Darkone83/Auto-RGB/img/ALS Board Back.png

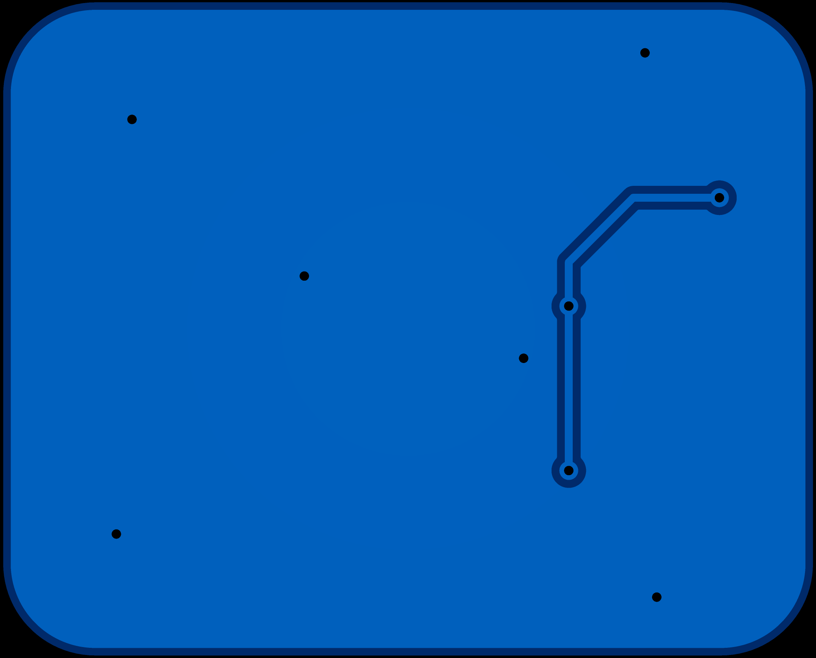
img/ALS Board Back.png
