Darkone83/Auto-RGB/img/ALS Board Front.png

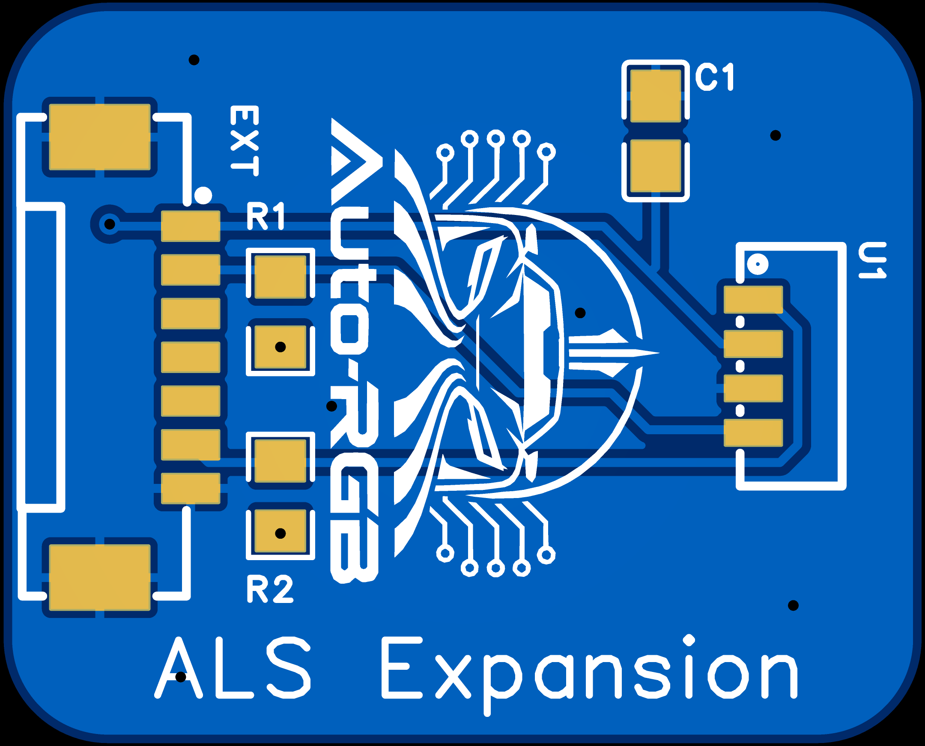
img/ALS Board Front.png
