Darkone83/Auto-RGB/img/ALS Board Schematic.png

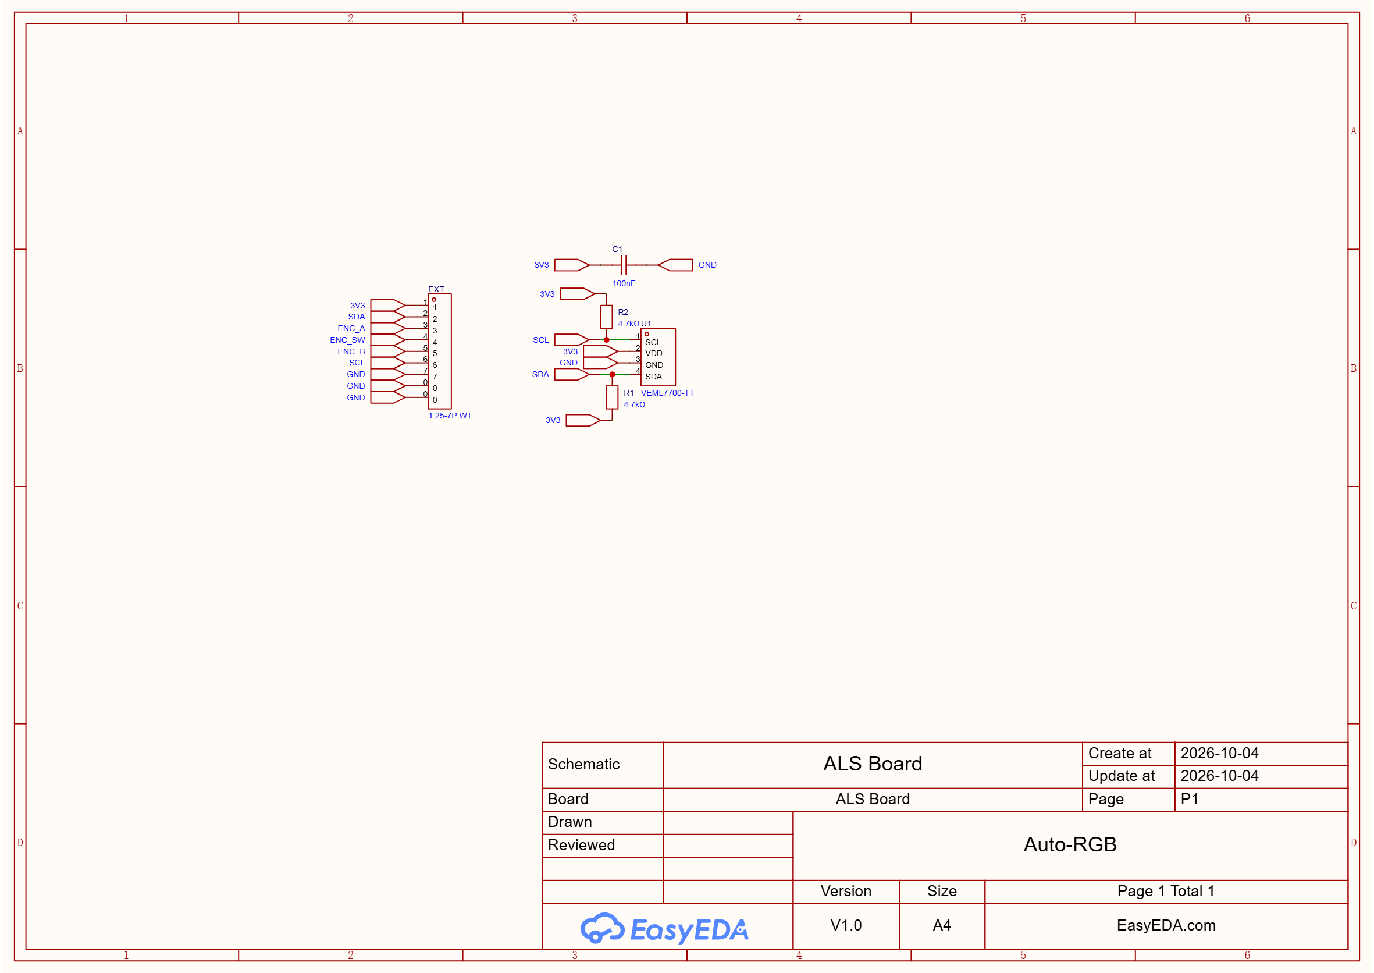
img/ALS Board Schematic.png
