Darkone83/Auto-RGB/img/EXP Hub Back.png

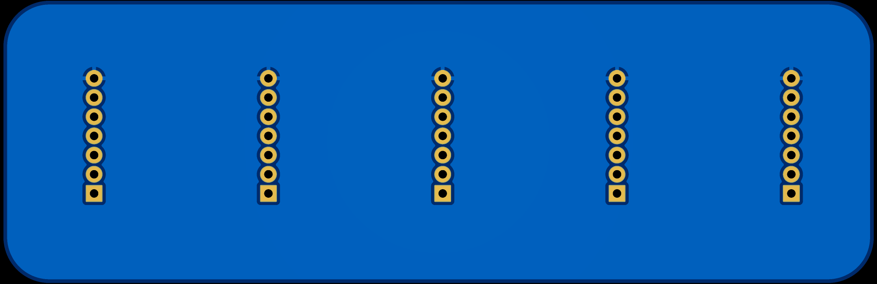
img/EXP Hub Back.png
