Darkone83/Auto-RGB/img/EXP Hub Front.png

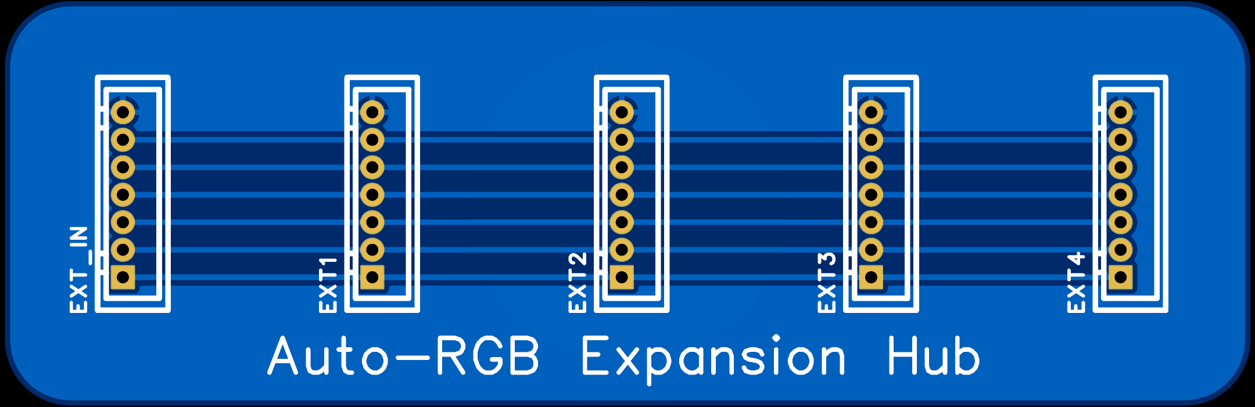
img/EXP Hub Front.png
