Darkone83/Auto-RGB/img/EXP Hub Schematic.png

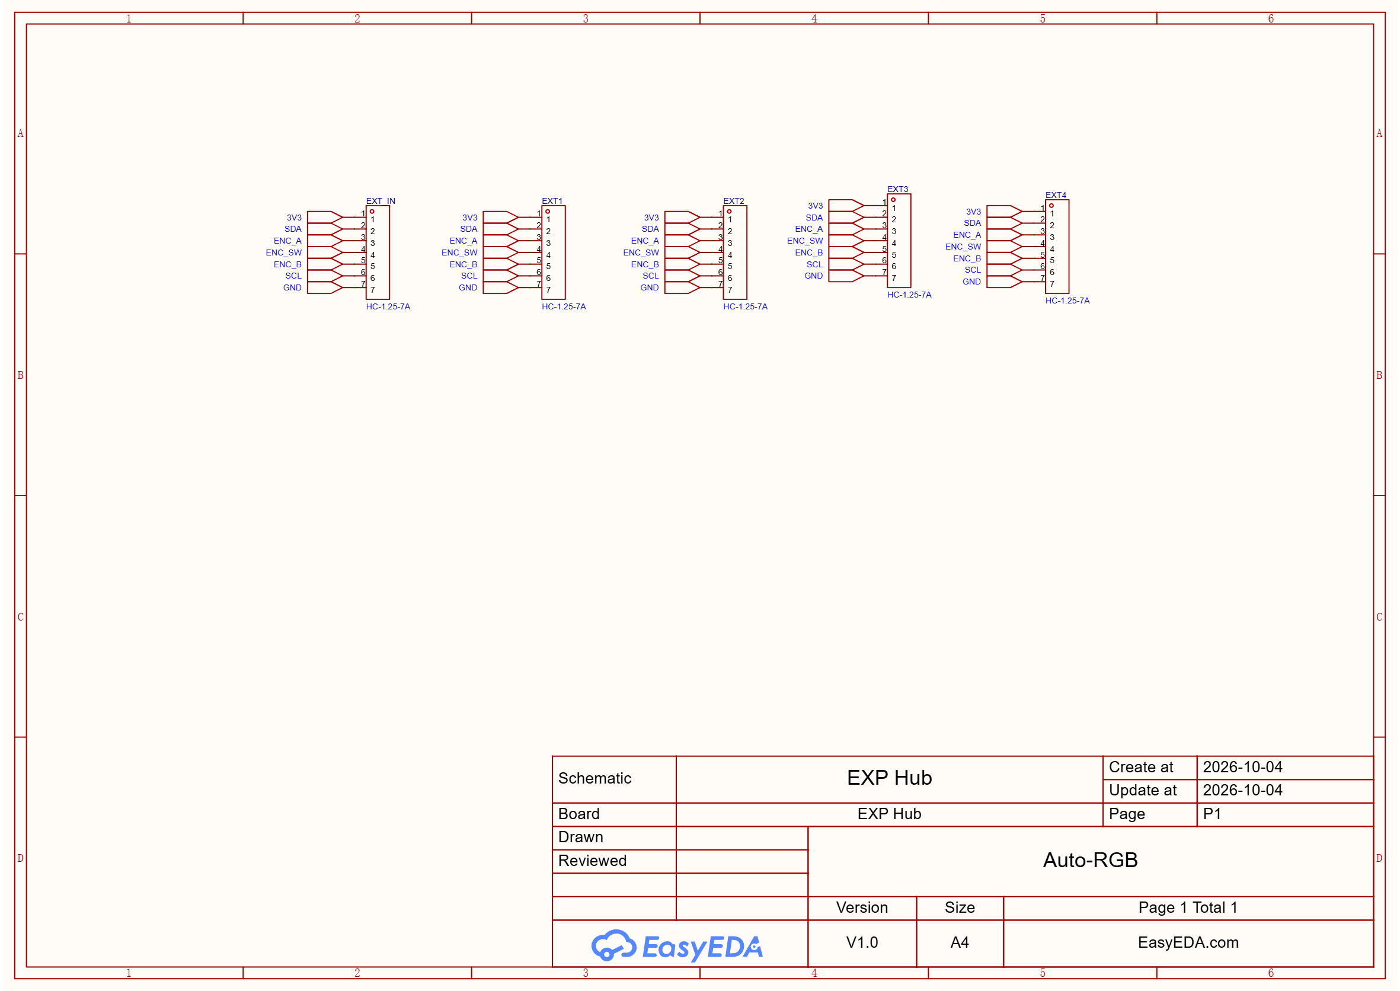
img/EXP Hub Schematic.png
