Darkone83/Auto-RGB/img/LED Board Back.png

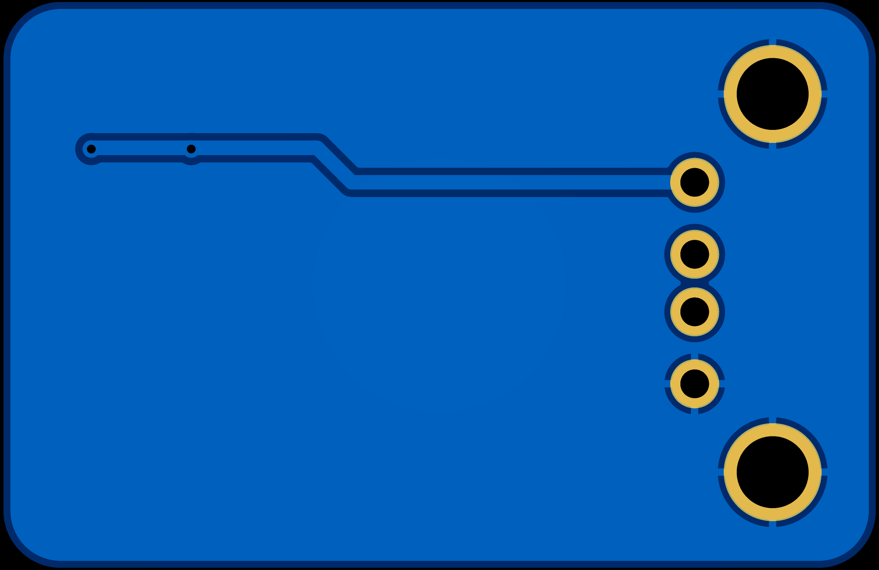
img/LED Board Back.png
