Darkone83/Auto-RGB/img/LED Board Front.png

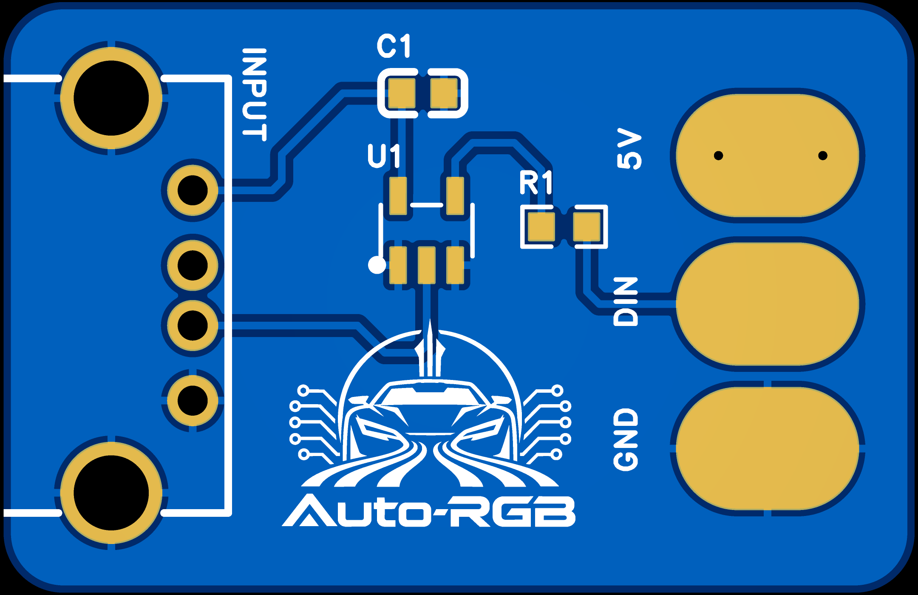
img/LED Board Front.png
