Darkone83/Auto-RGB/img/LED Board Schematic.png

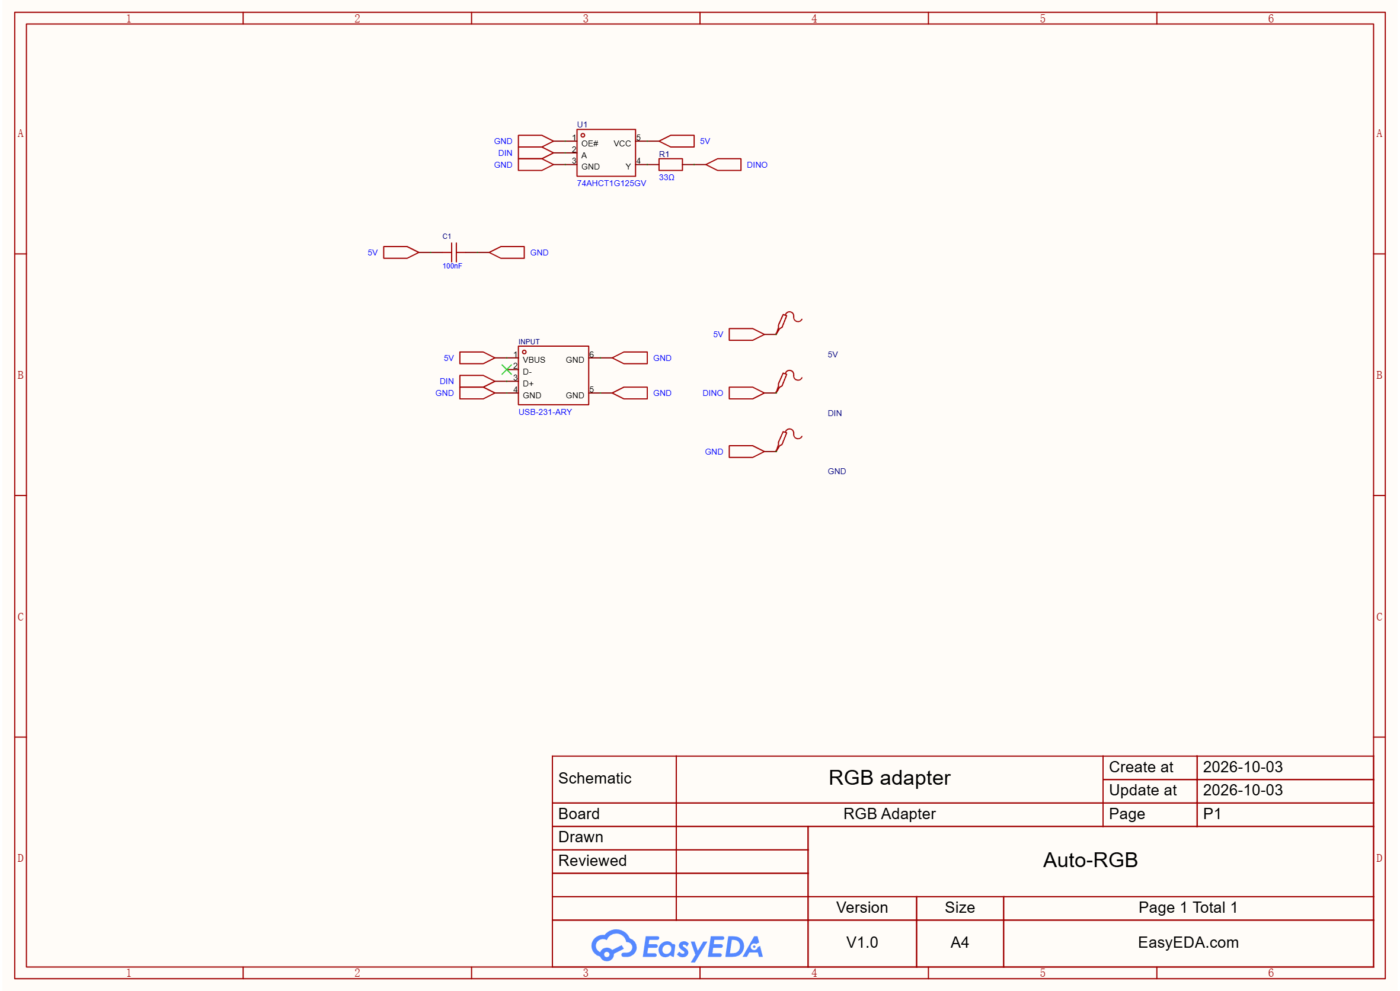
img/LED Board Schematic.png
