Darkone83/Auto-RGB/img/Main Board Back.png

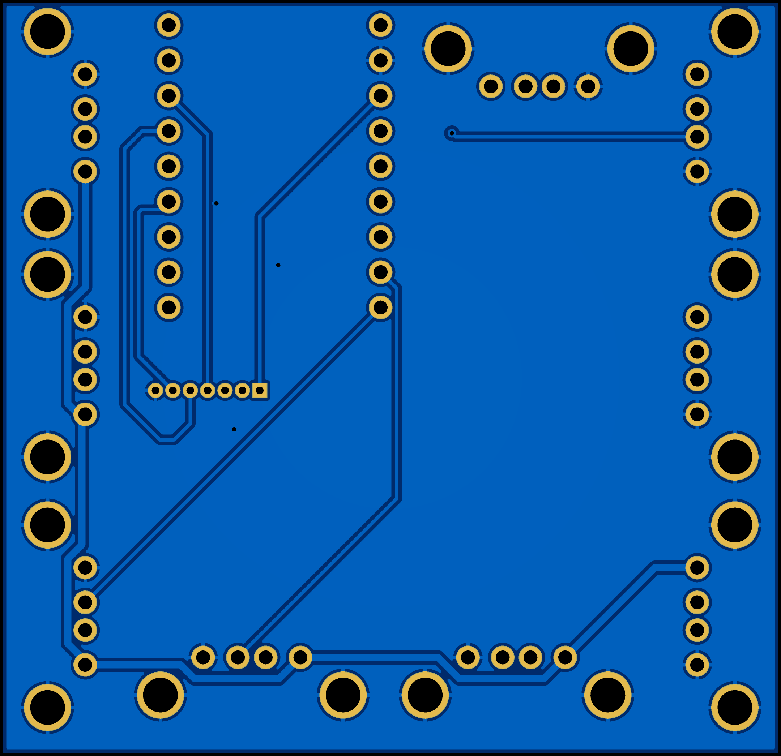
img/Main Board Back.png
