Darkone83/Auto-RGB/img/Main Board Front.png

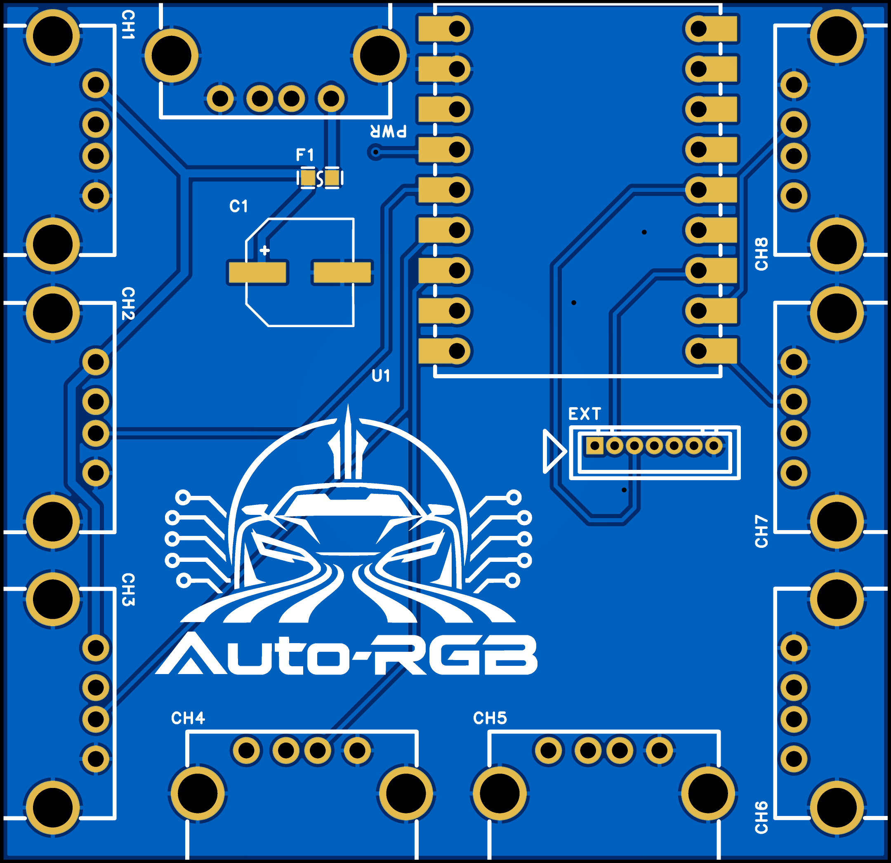
img/Main Board Front.png
