Darkone83/Auto-RGB/img/Main Board Schematic.png

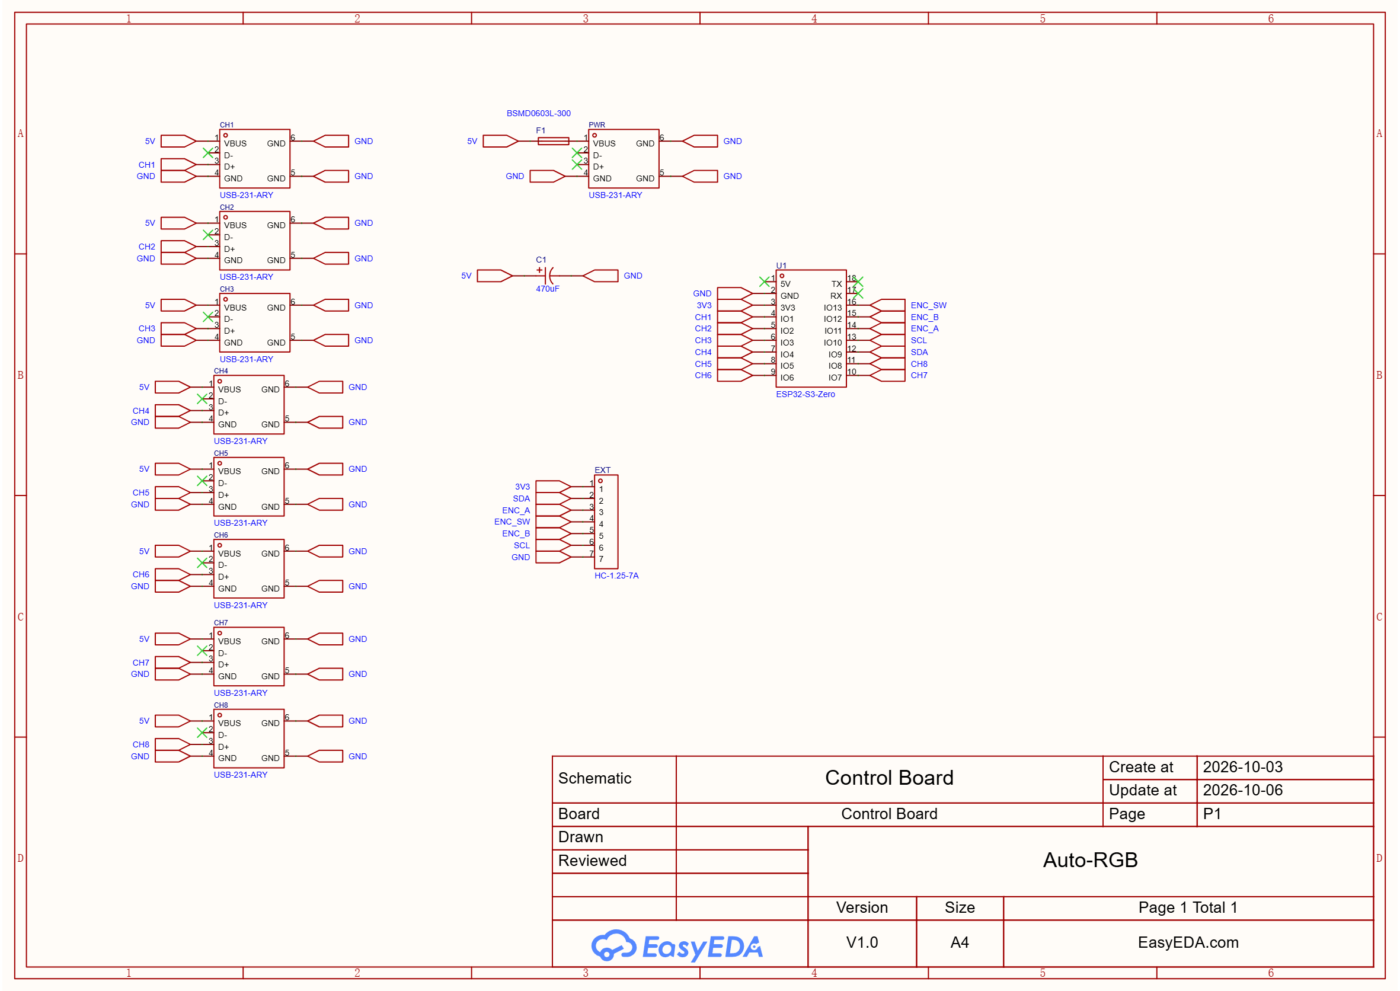
img/Main Board Schematic.png
