Darkone83/Auto-RGB/img/Remote Control Board Back.png

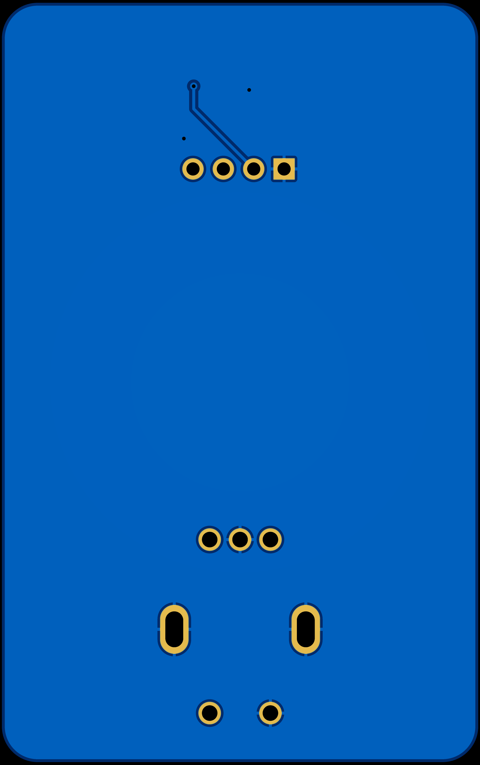
img/Remote Control Board Back.png
