Darkone83/Auto-RGB/img/Remote Control Board Front.png

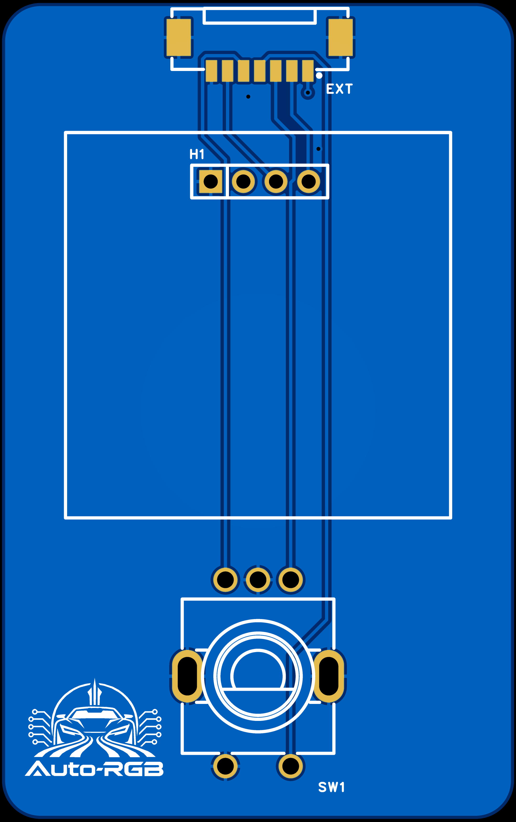
img/Remote Control Board Front.png
