Darkone83/Auto-RGB/img/Remote Control Board Schematic.png

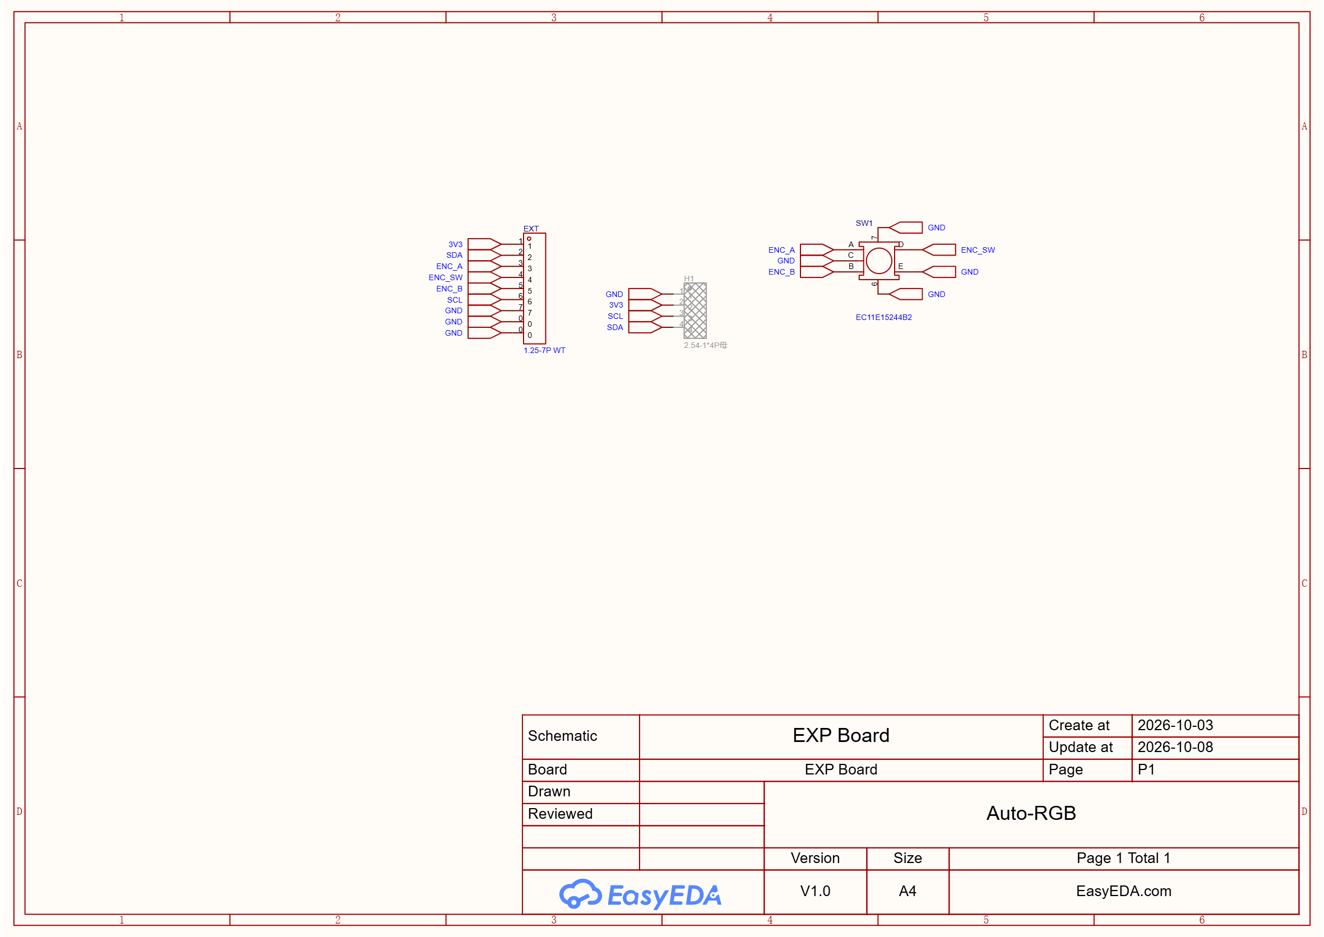
img/Remote Control Board Schematic.png
