Darkone83/Auto-RGB/img/RTC Board Back.png

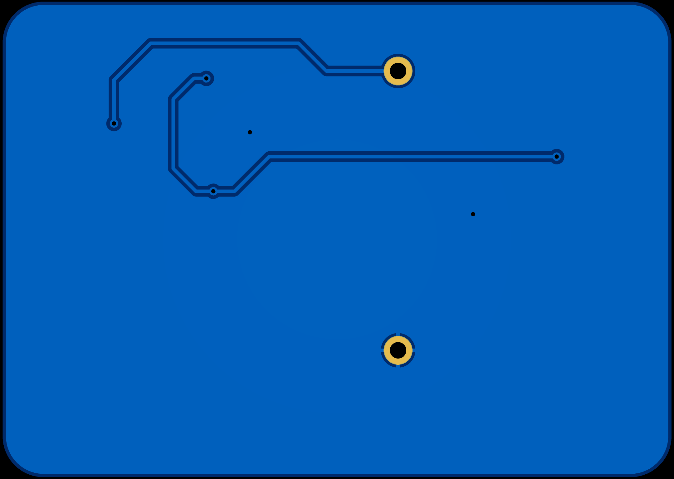
img/RTC Board Back.png
