Darkone83/Auto-RGB/img/RTC Board Front.png

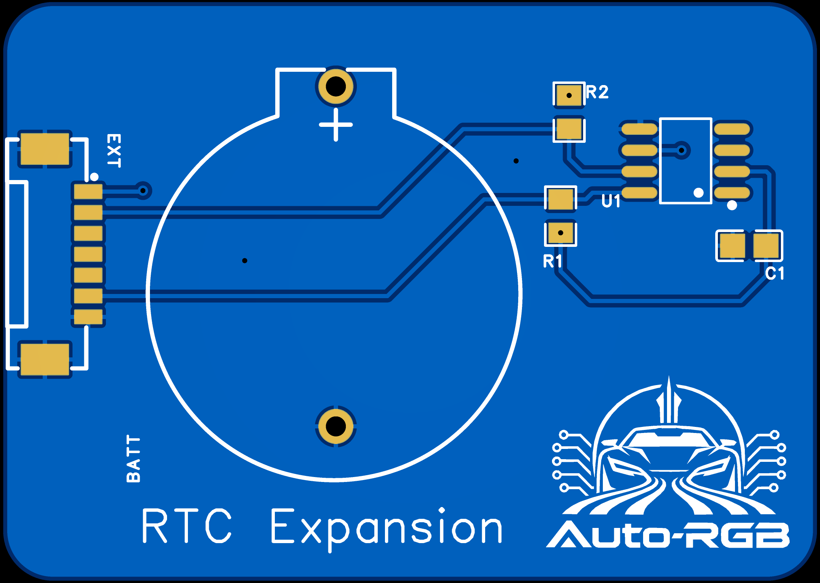
img/RTC Board Front.png
