Darkone83/Auto-RGB/img/RTC Board Schematic.png

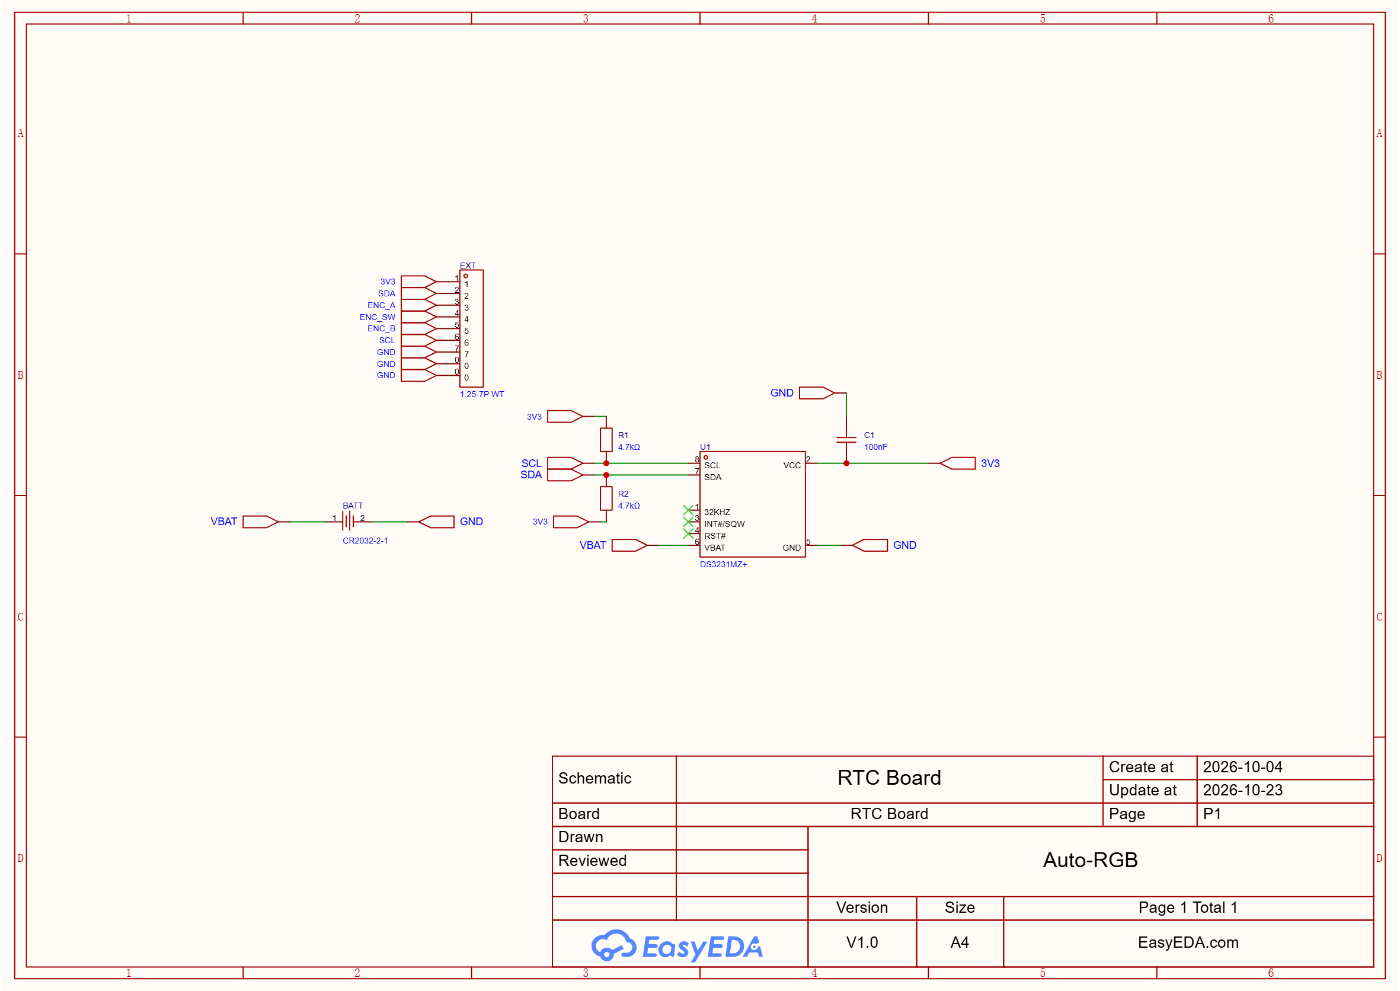
img/RTC Board Schematic.png
