Darkone83/Auto-RGB/PCBs/ALS Board/BOM.xlsx

No. | Quantity | Comment | Designator | Footprint | Value | Manufacturer Part | Manufacturer | Supplier Part | Supplier
1 | 1 | 100nF | C1 | C0805 | 100nF | CC0805KRX7R9BB104 | YAGEO(国巨) | C49678 | LCSC
2 | 1 | 1.25-7P WT | EXT | CONN-SMD_7P-P1.25-L4.4-W13.5 |  | 1.25-7P WT | SHOU HAN(首韩) | C2681528 | LCSC
3 | 2 | 4.7kΩ | R1,R2 | R0805 | 4.7kΩ | FRC0805F4701TS | FOJAN(富捷) | C2907264 | LCSC
4 | 1 | VEML7700-TT | U1 | SENSOR-SMD_EML7700-TT |  | VEML7700-TT | VISHAY(威世) | C1850416 | LCSC
