Darkone83/Auto-RGB/PCBs/EXP Hub/BOM.xlsx

No. | Quantity | Comment | Designator | Footprint | Value | Manufacturer Part | Manufacturer | Supplier Part | Supplier
1 | 5 | HC-1.25-7A | EXT1,EXT2,EXT3,EXT4,EXT_IN | CONN-TH_7P-P1.25_HCTL_HC-1.25-7A |  | HC-1.25-7A | HCTL(华灿天禄) | C2845525 | LCSC
