Darkone83/Auto-RGB/PCBs/Led Strip Board/BOM.xlsx

No. | Quantity | Comment | Designator | Footprint | Value | Manufacturer Part | Manufacturer | Supplier Part | Supplier
1 | 3 | Test-Point | 5V,DIN,GND | Test-Point-0.5mm
2 | 1 | 100nF | C1 | C0603 | 100nF | CC0603KRX7R9BB104 | YAGEO(国巨) | C14663 | LCSC
3 | 1 | USB-231-ARY | INPUT | USB-A-TH_USB-231-ARY |  | USB-231-ARY | XUNPU(讯普) | C720525 | LCSC
4 | 1 | 33Ω | R1 | R0603 | 33Ω | FRC0603F33R0TS | FOJAN(富捷) | C2909394 | LCSC
5 | 1 | 74AHCT1G125GV | U1 | SOT-23-5_L3.0-W1.7-P0.95-LS2.8-BL |  | 74AHCT1G125GV | MDD(辰达半导体) | C52140417 | LCSC
