Darkone83/Auto-RGB/PCBs/Main Board/BOM.xlsx

No. | Quantity | Comment | Designator | Footprint | Value | Manufacturer Part | Manufacturer | Supplier Part | Supplier
1 | 1 | 470uF | C1 | CAP-SMD_BD6.3-L6.6-W6.6-FD_RYHV25V220UF6X7 | 470uF | MA6.3V470M6X8 | JIERR(捷而瑞) | C54321567 | LCSC
2 | 9 | USB-231-ARY | CH1,CH2,CH3,CH4,CH5,CH6,CH7,CH8,PWR | USB-A-TH_USB-231-ARY |  | USB-231-ARY | XUNPU(讯普) | C720525 | LCSC
3 | 1 | HC-1.25-7A | EXT | CONN-TH_7P-P1.25_HCTL_HC-1.25-7A |  | HC-1.25-7A | HCTL(华灿天禄) | C2845525 | LCSC
4 | 1 | BSMD0603L-300 | F1 | F0603 |  | BSMD0603L-300 | BHFUSE(佰宏) | C5374008 | LCSC
5 | 1 | ESP32-S3-Zero | U1 | COMM-SMD_18P-P2.54-L23.5-W18.0-TL |  | ESP32-S3-Zero |  | C9900152785 | LCSC
