Darkone83/Auto-RGB/PCBs/Remote Control/BOM.xlsx

No. | Quantity | Comment | Designator | Footprint | Value | Manufacturer Part | Manufacturer | Supplier Part | Supplier
1 | 1 | 1.25-7P WT | EXT | CONN-SMD_7P-P1.25-L4.4-W13.5 |  | 1.25-7P WT | SHOU HAN(首韩) | C2681528 | LCSC
2 | 1 | 2.54-1*4P母 | H1 | HDR-TH_4P-P2.54-V-F |  | 2.54-1*4P母 | BOOMELE(博穆精密) | C2718488 | LCSC
3 | 1 | EC11E15244B2 | SW1 | SW-TH_EC11XXXXXXXX |  | EC11E15244B2 | ALPSALPINE(阿尔卑斯阿尔派) | C470754 | LCSC
