Darkone83/Auto-RGB/PCBs/RTC Board/BOM.xlsx

No. | Quantity | Comment | Designator | Footprint | Value | Manufacturer Part | Manufacturer | Supplier Part | Supplier
1 | 1 | CR2032-2-1 | BATT | BAT-TH_CR2032-2-1 |  | CR2032-2-1 |  | C9900018737 | LCSC
2 | 1 | 100nF | C1 | C0805 | 100nF | CC0805KRX7R9BB104 | YAGEO(国巨) | C49678 | LCSC
3 | 1 | 1.25-7P WT | EXT | CONN-SMD_7P-P1.25-L4.4-W13.5 |  | 1.25-7P WT | SHOU HAN(首韩) | C2681528 | LCSC
4 | 2 | 4.7kΩ | R1,R2 | R0805 | 4.7kΩ | FRC0805F4701TS | FOJAN(富捷) | C2907264 | LCSC
5 | 1 | DS3231MZ+ | U1 | SOIC-8_L4.9-W3.9-P1.27-LS6.0-BL |  | DS3231MZ+ | ADI(亚德诺)/MAXIM(美信) | C722467 | LCSC
