Darkone83/Auto-RGB/STL/Main Board/MainBoard_Lid_Rev2_ThroughWindowSnap.stl

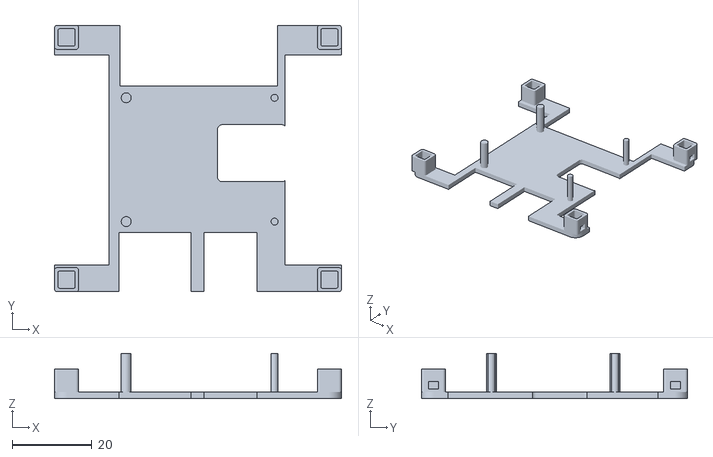
[picture p20: CAD file, 2026-10-25]
STL/Main Board/MainBoard_Lid_Rev2_ThroughWindowSnap.stl
72.0 x 66.8 x 11.4
