Darkone83/Auto-RGB/STL/Main Board/MainBoard_Base_Rev2_ThroughWindowSnap.stl

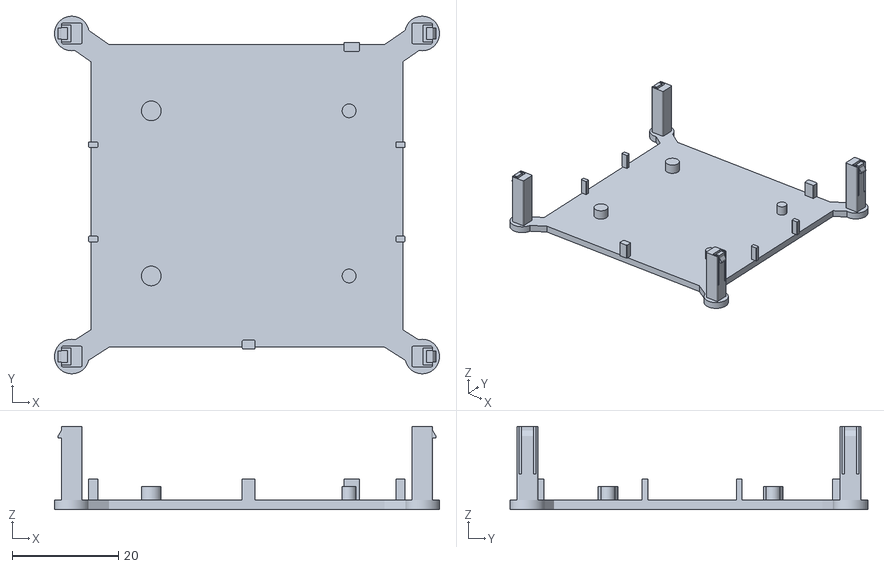
[picture p21: CAD file, 2026-10-25]
STL/Main Board/MainBoard_Base_Rev2_ThroughWindowSnap.stl
72.4 x 67.2 x 15.6
