Darkone83/Auto-RGB/STL/ALS Case/ALS_Lid_Snap_Rev4.stl

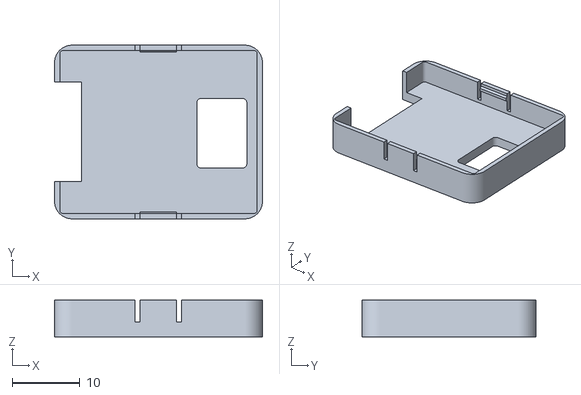
[picture p22: CAD file, 2026-10-25]
STL/ALS Case/ALS_Lid_Snap_Rev4.stl
30.8 x 25.7 x 5.40
