Darkone83/Auto-RGB/STL/Exp Hub/HUB_Back_Compact_Snap_Rev1.stl

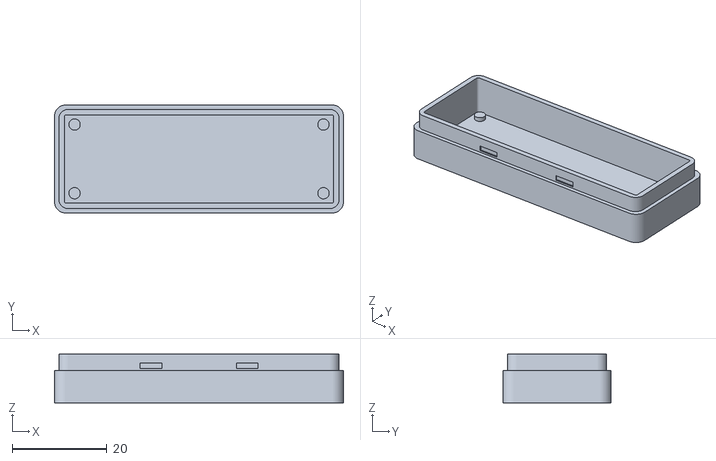
[picture p23: CAD file, 2026-10-25]
STL/Exp Hub/HUB_Back_Compact_Snap_Rev1.stl
61.0 x 22.8 x 10.3
