Darkone83/Auto-RGB/STL/Remote Case/AutoRGB_Dial_LongReach_Easy_6mmD.stl

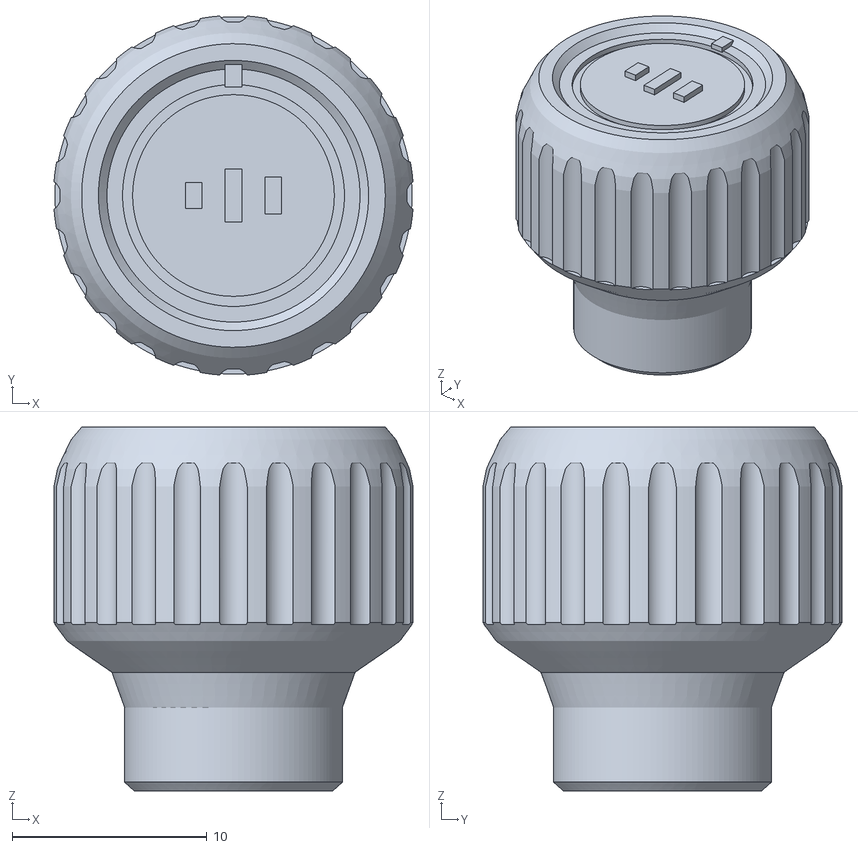
[picture p24: CAD file, 2026-10-25]
STL/Remote Case/AutoRGB_Dial_LongReach_Easy_6mmD.stl
18.4 x 18.4 x 18.7
