Darkone83/Auto-RGB/STL/RTC Case/RTC_Lid_Snap_Rev1.stl

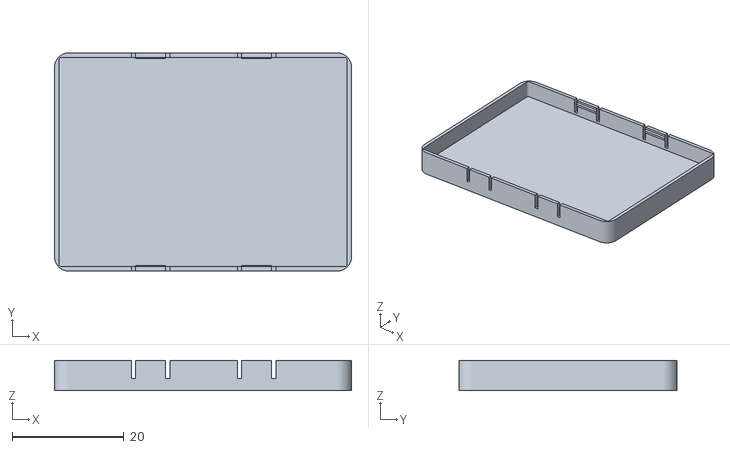
[picture p25: CAD file, 2026-10-25]
STL/RTC Case/RTC_Lid_Snap_Rev1.stl
53.2 x 39.1 x 5.40
