Darkone83/Auto-RGB/STL/ALS Case/ALS_Back_Compact_Rev4.stl

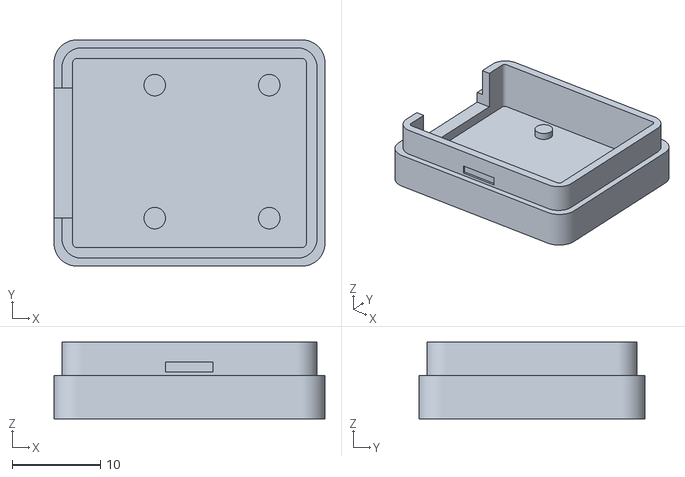
[picture p26: CAD file, 2026-10-25]
STL/ALS Case/ALS_Back_Compact_Rev4.stl
30.8 x 25.7 x 8.70
