Darkone83/Auto-RGB/STL/Exp Hub/HUB_Lid_5Port_Snap_Rev1.stl

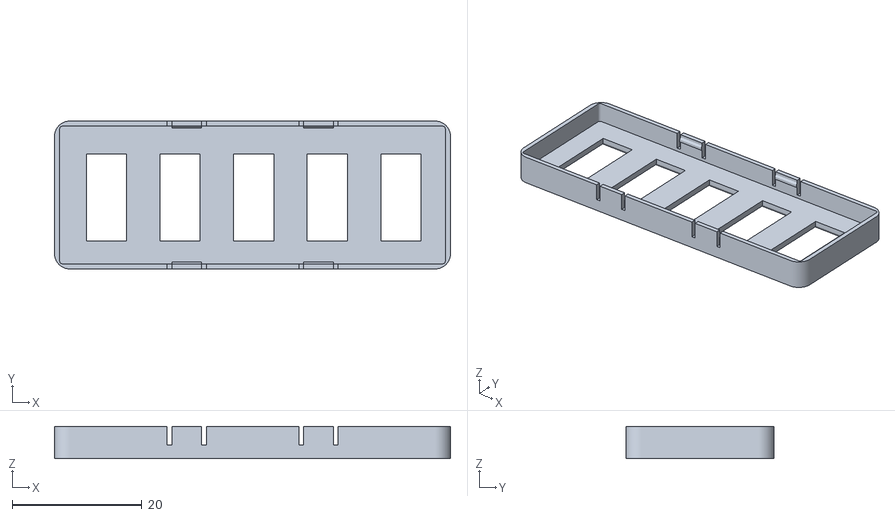
[picture p27: CAD file, 2026-10-25]
STL/Exp Hub/HUB_Lid_5Port_Snap_Rev1.stl
61.0 x 22.8 x 4.95
