Darkone83/Auto-RGB/STL/Remote Case/OLED_Lid_Snap_Rev4.stl

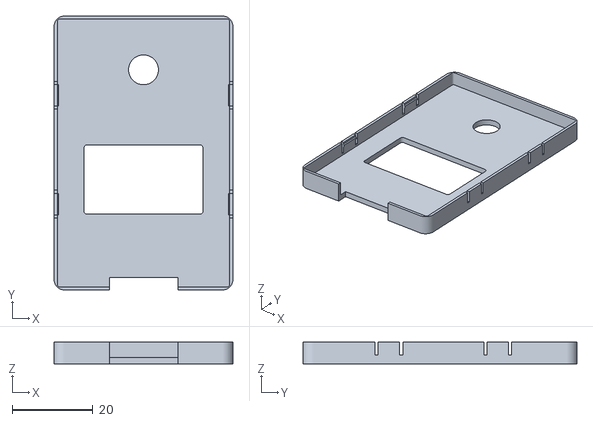
[picture p28: CAD file, 2026-10-25]
STL/Remote Case/OLED_Lid_Snap_Rev4.stl
44.4 x 68.0 x 5.40
