Darkone83/Auto-RGB/STL/RTC Case/RTC_Back_Snap_Rev1.stl

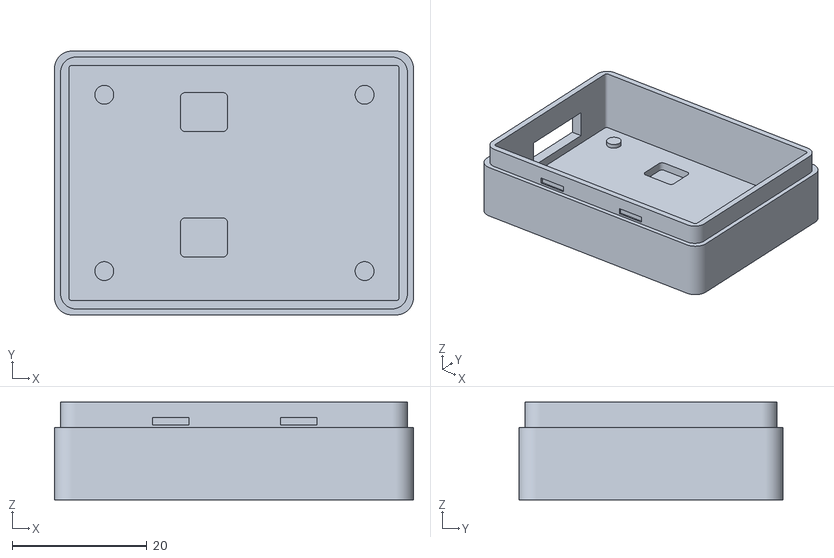
[picture p29: CAD file, 2026-10-25]
STL/RTC Case/RTC_Back_Snap_Rev1.stl
53.2 x 39.1 x 14.5
