Darkone83/Auto-RGB/STL/Remote Case/OLED_Back_Compact_Rev4.stl

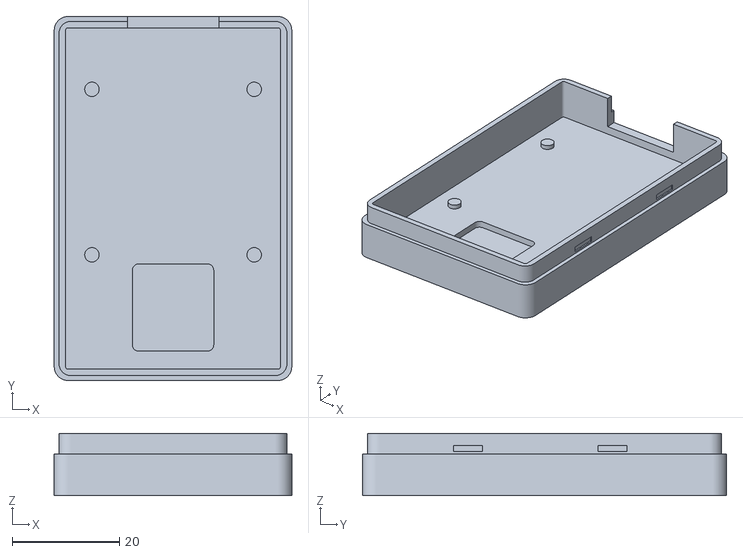
[picture p30: CAD file, 2026-10-25]
STL/Remote Case/OLED_Back_Compact_Rev4.stl
44.4 x 68.0 x 11.6
