Darkone83/Auto-RGB/src/components/remote_control/include/auto_rgb_oled_logo.hpp

#pragma once

#include <array>
#include <cstdint>

namespace auto_rgb_oled_logo {

// 128x64 monochrome Auto-RGB splash bitmap in SSD1306 page-major format.
// Generated from the project Auto-RGB logo artwork.
inline constexpr std::array<uint8_t, 1024> kBitmap{{
    0x00, 0x00, 0x00, 0x00, 0x00, 0x00, 0x00, 0x00, 0x00, 0x00, 0x00, 0x00, 0x00, 0x00, 0x00, 0x00,
    0x00, 0x00, 0x00, 0x00, 0x00, 0x00, 0x00, 0x00, 0x00, 0x00, 0x00, 0x00, 0x00, 0x00, 0x00, 0x00,
    0x00, 0x00, 0x00, 0x00, 0x00, 0x00, 0x00, 0x00, 0x00, 0x00, 0x00, 0x80, 0x80, 0x80, 0xC0, 0xC0,
    0x40, 0x60, 0x60, 0x60, 0x20, 0x30, 0x30, 0x30, 0x10, 0x10, 0x10, 0x18, 0x98, 0xC0, 0x00, 0xE0,
    0xFE, 0xF8, 0x00, 0xC0, 0x80, 0x18, 0x10, 0x10, 0x10, 0x30, 0x30, 0x30, 0x30, 0x20, 0x60, 0x60,
    0x60, 0xC0, 0xC0, 0xC0, 0x80, 0x80, 0x00, 0x00, 0x00, 0x00, 0x00, 0x00, 0x00, 0x00, 0x00, 0x00,
    0x00, 0x00, 0x00, 0x00, 0x00, 0x00, 0x00, 0x00, 0x00, 0x00, 0x00, 0x00, 0x00, 0x00, 0x00, 0x00,
    0x00, 0x00, 0x00, 0x00, 0x00, 0x00, 0x00, 0x00, 0x00, 0x00, 0x00, 0x00, 0x00, 0x00, 0x00, 0x00,
    0x00, 0x00, 0x00, 0x00, 0x00, 0x00, 0x00, 0x00, 0x00, 0x00, 0x00, 0x00, 0x00, 0x00, 0x00, 0x00,
    0x00, 0x00, 0x00, 0x00, 0x00, 0x00, 0x00, 0x00, 0x00, 0x00, 0x00, 0x00, 0x00, 0x00, 0x00, 0x80,
    0xC0, 0xE0, 0x70, 0x30, 0x18, 0x1C, 0x0C, 0x06, 0x06, 0x03, 0x03, 0x01, 0x01, 0x00, 0x00, 0x00,
    0x00, 0x00, 0x00, 0x00, 0x00, 0x00, 0x00, 0x00, 0x00, 0x00, 0x02, 0x0F, 0xFF, 0xFF, 0x00, 0xFF,
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
    0xC0, 0xF0, 0xFC, 0x00, 0x0F, 0xFF, 0xF0, 0x1F, 0x07, 0x10, 0x18, 0x8C, 0xC4, 0xC6, 0x63, 0x31,
    0x31, 0x30, 0x30, 0x30, 0x30, 0x30, 0x30, 0x30, 0x30, 0x31, 0x7B, 0x4A, 0x7B, 0x31, 0x00, 0x00,
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
}};

} // namespace auto_rgb_oled_logo
